AfonsoTex/autonomous-fire-robot/docs/README.md

# Project documentation

## [Technical Report](Technical_Report.pdf)

**Start here: the full engineering report for the firefighting robot.**

The report covers the project's design, electronics, software, flame detection
and aiming system. It stays at the top level of this folder; supporting material
is organised below.

---

## Supporting material

| Folder | Contents |
| --- | --- |
| [Datasheets](datasheets/) | ESP32-CAM schematic, ESP32 technical reference manual and OV2640 sensor datasheet. |
| [Photos](photos/) | Complete robot, printed chassis and ESP32-CAM housing. |
| [Diagrams](diagrams/) | System architecture diagram. |

## Reference documents

- [ESP32-CAM V1.6 schematic](datasheets/ESP32_CAM_V1.6.pdf)
- [ESP32 technical reference manual](datasheets/esp32_technical_reference_manual_en.pdf)
- [OV2640 sensor datasheet](datasheets/OV2640DS.pdf)

## Related project files

- [Phase III objectives](../PHASE_III.pdf): goal and problems of this phase.
- [Hardware guide](../hardware/README.md): wiring and chassis files.
- [Project overview](../README.md): features, setup and demonstration.
