AfonsoTex/autonomous-fire-robot/firmware/raspberry/servos.cpp

#include "servos.h"

#include <filesystem>
#include <fstream>
#include <string>

// On the current Pi configuration, pwmchip1 is PWM0 (device 1f00098000.pwm).
// GPIO18 uses channel 2 and GPIO19 uses channel 3. pwmchip0 belongs to the fan.
// Check this path again after reboot or PWM configuration changes.
static const std::string PWMCHIP = "/sys/class/pwm/pwmchip1";

bool initializeServos(int pan_us, int tilt_us)
{
    if (pan_us < MIN_PULSE_US || pan_us > MAX_PULSE_US ||
        tilt_us < MIN_PULSE_US || tilt_us > MAX_PULSE_US) return false;
    if (!std::filesystem::exists(PWMCHIP + "/pwm2")) {
        std::ofstream f(PWMCHIP + "/export");
        if (!f) {
            return false;
        }
        f << 2;
        f.flush();
        if (!f) {
            return false;
        }
    }
    if (!std::filesystem::exists(PWMCHIP + "/pwm3")) {
        // Export the channel if it is not available yet.
        std::ofstream f(PWMCHIP + "/export");
        if (!f) {
            return false;
        }
        f << 3;
        f.flush();
        if (!f) {
            return false;
        }
    }

    // Disable both outputs before changing their period or initial position.
    for (const char* channel : {"/pwm2/enable", "/pwm3/enable"}) {
        std::ofstream output(PWMCHIP + channel);
        if (!output) {
            return false;
        }
        output << 0;
        output.flush();
        if (!output) {
            return false;
        }
    }

    {
        std::ofstream f(PWMCHIP + "/pwm2/period");
        if (!f) {
            return false;
        }
        f << 20000000;
        f.flush();
        if (!f) {
            return false;
        }
    }
    {
        std::ofstream f(PWMCHIP + "/pwm2/duty_cycle");
        if (!f) {
            return false;
        }
        f << pan_us * 1000;
        f.flush();
        if (!f) {
            return false;
        }
    }

    {
        std::ofstream f(PWMCHIP + "/pwm2/enable");
        if (!f) {
            return false;
        }
        f << 1;
        f.flush();
        if (!f) {
            return false;
        }
    }
    {
        std::ofstream f(PWMCHIP + "/pwm3/period");
        if (!f) {
            return false;
        }
        f << 20000000;
        f.flush();
        if (!f) {
            return false;
        }
    }
    {
        std::ofstream f(PWMCHIP + "/pwm3/duty_cycle");
        if (!f) {
            return false;
        }
        f << tilt_us * 1000;
        f.flush();
        if (!f) {
            return false;
        }
    }
    {
        std::ofstream f(PWMCHIP + "/pwm3/enable");
        if (!f) {
            return false;
        }
        f << 1;
        f.flush();
        if (!f) {
            return false;
        }
    }

    return true;
}

bool setServoPulse(int gpio, int pulse_us)
{
    // Accepts only the pins selected in servos.h.
    if (gpio != GPIO_PAN and gpio != GPIO_TILT) {
        return false;
    }

    // Invalid requests leave any existing pulse signal unchanged.
    if (pulse_us < MIN_PULSE_US or pulse_us > MAX_PULSE_US) {
        return false;
    }

    // Each GPIO pin is wired by the hardware to one PWM channel.
    std::string channel;
    if (gpio == GPIO_PAN) {
        channel = "/pwm2";
    } else if (gpio == GPIO_TILT) {
        channel = "/pwm3";
    }

    std::ofstream f(PWMCHIP + channel + "/duty_cycle");
    if (!f) {
        return false;
    }

    // Converts microseconds to nanoseconds, the unit sysfs accepts.
    f << pulse_us * 1000;
    f.flush();
    if (!f) {
        return false;
    }

    return true;
}

void shutdownServos()
{
    // Attempt both channels even if one cannot be disabled.
    for (const char* channel : {"/pwm2/enable", "/pwm3/enable"}) {
        std::ofstream f(PWMCHIP + channel);
        if (f) { f << 0; f.flush(); }
    }
}
