AfonsoTex/autonomous-fire-robot/firmware/raspberry/camera.h

#ifndef CAMERA_H
#define CAMERA_H

#include <opencv2/opencv.hpp> 
// Includes OpenCV image processing and video capture interfaces.

class Camera{
    private:
        cv::VideoCapture cap;

    public:
        Camera();
        ~Camera();

        bool open(int index = 0);
        bool readFrame(cv::Mat& frame);
        void release();
};
#endif
