AfonsoTex/autonomous-fire-robot/(commit log)

2026-10-20 Add shared settings, car stop control and reflection filter; update READMEs
    - Move tunable values into firmware/raspberry/settings.h, read by C++ and Python
    - Add car movement permission (car_control) and NMS (detection_filter)
    - Filter post-spray reflections and ignore unreachable targets
    - Update READMEs to match the code; clearer architecture diagram
    - Remove unused images and the outdated build section
2026-10-20 Add wiring diagrams to hardware, keep only the firefighting demo
2026-10-20 Add NEXT_PHASE plan: SLAM, thermal camera, encoders, PCB, refill station
2026-10-20 NEXT_PHASE: vibration, stabilised camera and spraying while driving
2026-10-20 Document servo position feedback upgrade
